ShujiMikami/kicadTraning/firstTraining.kicad_pcb

## KiCad design firstTraining.kicad_pcb (2018-11-18)

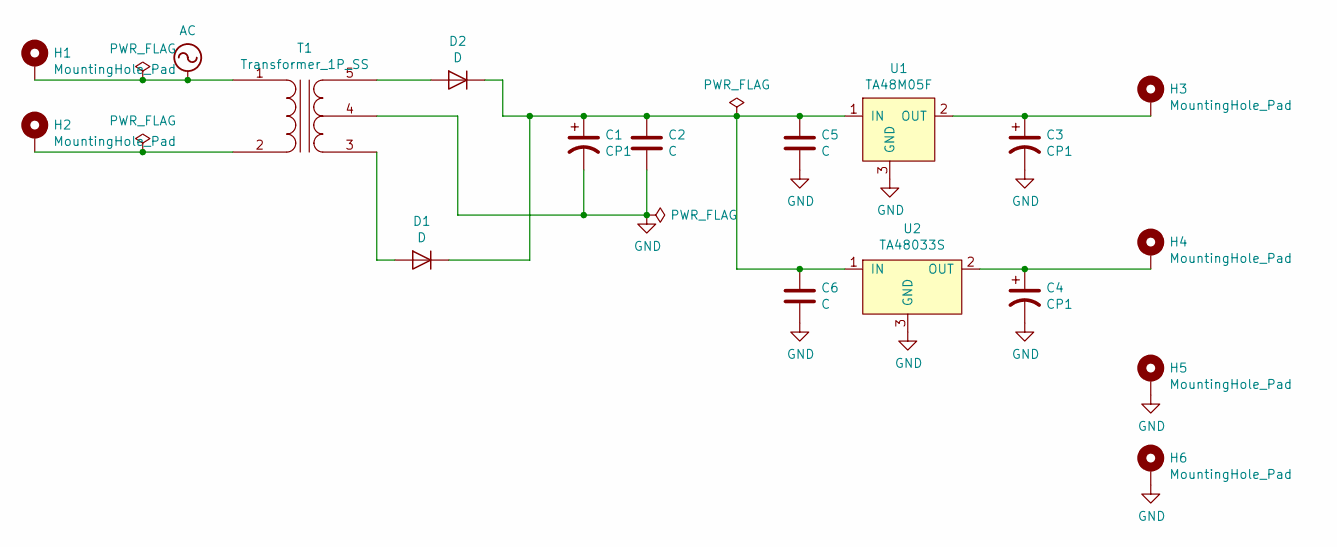
[picture p1: schematic firstTraining.sch]

Parts:
C1: CP1; CP_Radial_D18.0mm_P7.50mm
C2, C5, C6: C; C_Disc_D3.0mm_W1.6mm_P2.50mm
C3, C4: CP1; CP_Radial_D5.0mm_P2.00mm
D1, D2: D; D_A-405_P7.62mm_Horizontal
H1, H2: MountingHole_Pad; MountingHole_4.5mm_Pad_Via
H3, H4, H5, H6: MountingHole_Pad; PinHeader_1x01_P2.54mm_Horizontal
T1: Transformer_1P_SS; HP-098
U1: TA48M05F; TOSHIBA_DIP_Regulators
U2: TA48033S; TOSHIBA_DIP_Regulators

Connections:
AC: H1.1, T1.1 (AA)
GND: C1.2, C2.2, C3.2, C4.2, C5.2, C6.2, H5.1, H6.1, T1.4 (SC), U1.3 (GND), U2.3 (GND)
unnamed: C1.1, C2.1, C5.1, C6.1, D1.1 (K), D2.1 (K), U1.1 (IN), U2.1 (IN)
unnamed: C3.1, H3.1, U1.2 (OUT)
unnamed: C4.1, H4.1, U2.2 (OUT)
unnamed: D1.2 (A), T1.3 (SA)
unnamed: D2.2 (A), T1.5 (SB)
unnamed: H2.1, T1.2 (AB)

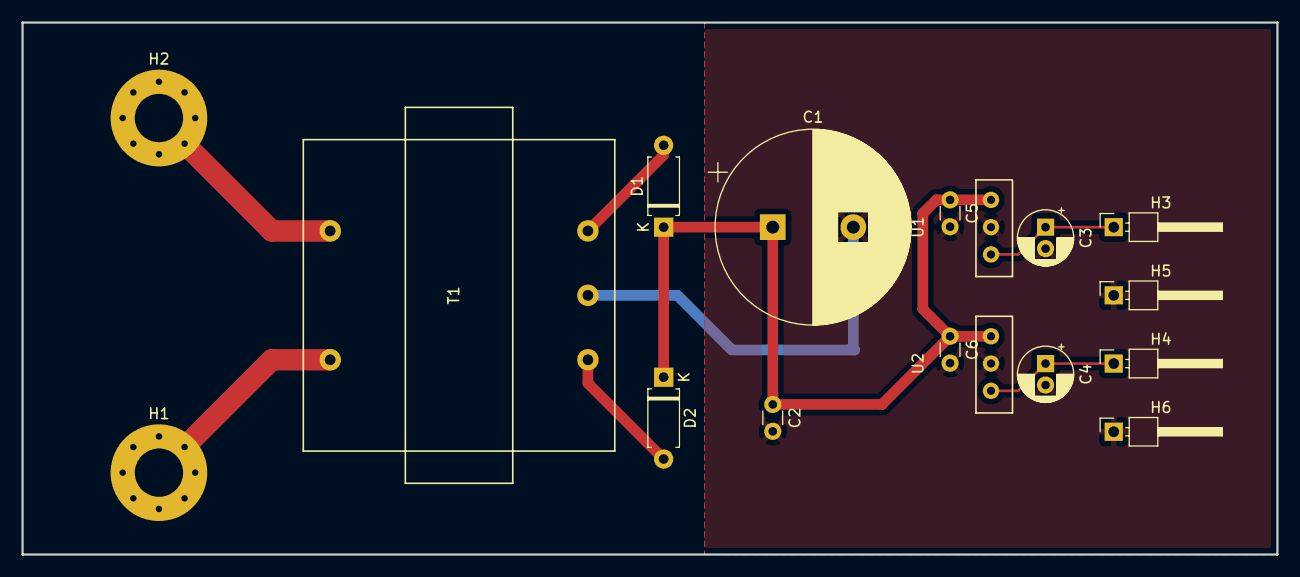
[picture p2: board firstTraining.kicad_pcb from above]

Board: 2 copper layers, 116.8 x 49.5 mm, 17 parts (0 on the bottom side), 8 nets.
