ShujiMikami/kicadTraning/(commit log)

2018-10-29 配線した
    [firstTraining.sch]
2018-10-29 部品の場所を再配置
    [firstTraining.sch]
2018-10-29 バックアップファイルを無視
2018-10-29 3V3電源を追加
    [firstTraining.sch]
2018-10-29 アノテーションとERC実行
    [firstTraining.sch]
2018-10-29 フットプリント設定, トランスはフットプリント要作成
    [firstTraining.sch]
2018-10-30 センタータップ式に修正
    [firstTraining.sch]
2018-10-30 フットプリント再実施
    [firstTraining.sch]
2018-10-30 トランスのフットプリント作成, フットプリント指定
2018-10-30 ネットリスト作成
2018-10-30 schが保存されていなかった
    [firstTraining.sch]
2018-10-30 レギュレータ部品を新たに作成
    [_saved_firstTraining.sch]
2018-10-30 GND配線の番号付与追加, 配置実施
    [_saved_firstTraining.sch, firstTraining.kicad_pcb, firstTraining.sch]
2018-10-31 パターン配線
    [firstTraining.kicad_pcb]
2018-10-31 GNDベタ
    [firstTraining.kicad_pcb]
2018-10-31 マウンティングホールを作成
    [firstTraining.sch]
2018-10-31 スルホとピンヘッダ設定
    [firstTraining.sch]
2018-10-31 ネットリスト更新
2018-10-31 パターン状にビアを追加
    [firstTraining.kicad_pcb]
2018-10-31 GNDビアを追加
    [firstTraining.kicad_pcb]
2018-10-31 GNDパッドに変更
    [firstTraining.sch]
2018-10-31 pcbのgndベタを修正
    [firstTraining.kicad_pcb]
2018-10-31 原点を追加
    [firstTraining.kicad_pcb]
2018-10-31 ガーバーデータを排出
    [firstTraining-B.Cu.gbr, firstTraining-B.Mask.gbr, firstTraining-B.Paste.gbr, firstTraining-B.SilkS.gbr, firstTraining-Edge.Cuts.gbr, firstTraining-F.Cu.gbr, firstTraining-F.Mask.gbr, firstTraining-F.Paste.gbr]
2018-10-31 ファイル名をElecrow仕様に合わせて修正
    [firstTraining-B.Paste.gbr, firstTraining-B.SilkS.gbr, firstTraining-NPTH.drl, firstTraining.gbl, firstTraining.gbo, firstTraining.gbs, firstTraining.gm1, firstTraining.gtl]
2018-10-31 Zip圧縮
2018-10-31 Elecrowの最大寸法に入れた
    [firstTraining.kicad_pcb]
2018-10-31 ガーバーを更新
    [firstTraining.gbl, firstTraining.gbo, firstTraining.gbs, firstTraining.gm1, firstTraining.gtl, firstTraining.gto, firstTraining.gts]
2018-11-17 ボードの仕上がりレポート作成
2018-11-17 レギュレータのコンデンサを入れ替え
    [firstTraining.sch]
2018-11-17 ネットリストを更新
2018-11-17 フットプリントとネットリスト更新
    [firstTraining.sch]
2018-11-17 レギュレータフットプリントを追加
2018-11-17 レギュレータのフットプリントを構成
2018-11-17 フットプリント更新した
    [firstTraining.sch]
2018-11-17 NETリスト更新, PCB図面新規作成
    [firstTraining.kicad_pcb]
2018-11-17 PCBを一部配線
    [firstTraining.kicad_pcb]
2018-11-17 GNDベタを追加
    [firstTraining.kicad_pcb]
2018-11-18 高電圧部分の太さを修正
    [firstTraining.kicad_pcb]
2018-11-18 ドリル原点指定
    [firstTraining.kicad_pcb]
2018-11-18 エッジカットのレイヤーに変更
    [firstTraining.kicad_pcb]
2018-11-18 ベタパターンを修正
    [firstTraining.kicad_pcb]
2018-11-18 ガーバーファイルを生成
    [firstTraining.kicad_pcb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]
